RonAaron61/MyEIT-V1.2/Assets/PCB/README.md

Use EasyEda to open this file

How to use：

At editor, open the document via: Top menu - File - Open - EasyEDA... , and select the json file, then open it at the editor, you can save it into a project.
