RonAaron61/MyEIT-V1.2/Assets/Program/Python/EIT_LIVE_JAC/eit_reconstruct_jac.py

from __future__ import absolute_import, division, print_function

import matplotlib.pyplot as plt
from matplotlib import colors
import numpy as np
#import pyeit.eit.bp as bp
import pyeit.eit.jac as jac
import pyeit.eit.protocol as protocol
import pyeit.mesh as mesh
from pyeit.eit.fem import EITForward
from pyeit.mesh import shape, distmesh, plot_distmesh
from pyeit.mesh.wrapper import PyEITAnomaly_Circle

import average  #Untuk merata-rata satu data aja

class EIT_reconstruct:
    def __init__ (self, data, reference = None, use_ref = 0, n_el = 16, use_shape = 3):
        self.n_el = n_el  # nb of electrodes
        self.use_shape = use_shape
        self.data = data
        self.reference = reference
        self.use_ref = use_ref
    
    def Reconstruct(self):

        """ 0. build mesh """
        if self.use_shape == 1:
            # Mesh shape is specified with fd parameter in the instantiation, e.g : fd=thorax
            # mesh_obj = mesh.create(n_el, h0=0.1, fd=thorax)
            mesh_obj = mesh.layer_circle(self.n_el, n_fan=15, n_layer=20)
            # n_fan dan n_layer diutak-atik buat jumlah mesh
        elif self.use_shape == 2:
            """Bulat biasa"""
            mesh_obj = mesh.create(self.n_el, h0=0.04)
            #h0 -> menentukan jumlah mesh
        elif self.use_shape == 3 :
            """unit circle mesh - Bulat dengan distmesh kyk eidors"""
            """ #Note: Buat make ini awal2 harus ngutak-ngatik di plot_mesh.py dulu, dan __init__.py nya"""
            def _fd(pts):
                """shape function"""
                return shape.circle(pts, pc=[0, 0], r=1.0)

            def _fh(pts):
                """distance function"""
                r2 = np.sum(pts**2, axis=1)
                return 0.2 * (2.0 - r2)

            # build fix points, may be used as the position for electrodes
            p_fix = shape.fix_points_circle(ppl=self.n_el)
            # firs num nodes are the positions for electrodes
            el_pos = np.arange(self.n_el)

            # build triangle
            #p, t = distmesh.build(_fd, _fh, pfix=p_fix, h0=0.05)
            mesh_obj = mesh.create(fd=_fd, fh=_fh, p_fix=p_fix, h0=0.024)
            #plot_distmesh(p, t, el_pos)
        elif self.use_shape == 4:
            mesh_obj = mesh.create(self.n_el, h0=0.1, fd=thorax)

        el_pos = mesh_obj.el_pos


        """ 1. FEM forward simulations """
        # setup EIT scan conditions
        # adjacent stimulation (dist_exc=1), adjacent measures (step_meas=1)
        protocol_obj = protocol.create(self.n_el, dist_exc=1, step_meas=1, parser_meas="std")
        print("Mesh done...")


        """ 2. naive inverse solver using back-projection """
        """BP Mehtohd"""
        #eit = bp.BP(mesh_obj, protocol_obj) #Backpropagation
        #eit.setup(weight="simple")  #Lebih bagus pake ini
        
        """JAC Mehod"""
        eit = jac.JAC(mesh_obj, protocol_obj)
        eit.setup(p=0.5, lamb=0.01, method="kotre", perm=1, jac_normalized=False)
        
        #eit.setup(weight="None")


        """ 3. Input Data """
        if self.use_ref == 1:     #Use existing reference data
            referenceData = np.array(self.reference)
            

        elif self.use_ref == 0:   #Create reference data from data
            referenceData = average.ave(data=self.data, n_elec=self.n_el)
            #referenceData = None

        #data = np.loadtxt('2_VrmsSpidolLogam20Knew3.csv', delimiter=',', dtype=float)   
        print("Input Data Done...")


        """ 4. Inverse Problem """
        node_ds = 192.0 * eit.solve(self.data, referenceData, normalize=True)
        #node_ds = 192.0 * eit.gn(self.data, referenceData, lamb_decay=0.1, lamb_min=1e-5, maxiter=20, verbose=True)

        # extract node, element, alpha
        pts = mesh_obj.node
        tri = mesh_obj.element

        """ Plot Hasil """
        print("Plotting result...")
        #Draw the number of electrode
        def dot_num(x, y, axn, n):
            elect = [1,2,3,4,5,6,7,8,9,10,11,12,13,14,15,16]
            for i in range(len(n)):
                el2 = el_pos[i]
                el = elect[i]
                xi = x[el2, 0]
                yi = y[el2, 1]
                offset = 0.06
                if round(xi,3) > 0:
                    xt = xi+offset-0.04       
                elif round(xi,3) < 0:
                    xt = xi-offset
                else:
                    xt = xi
                
                if round(yi,3) > 0:
                    yt = yi+offset-0.04
                elif round(yi,3) < 0:
                    yt = yi-offset
                else:
                    yt = yi

                axn.annotate(el, xy=(xt,yt))
        # draw
        fig, axes = plt.subplots(1, 1, constrained_layout=True, figsize=(6, 6))


        # Mesh - plot the mesh
        """ax2 = axes[0]
        ax2.triplot(pts[:, 0], pts[:, 1], tri, linewidth=1) #pts[:, 1], pts[:, 0] -> kebalik urutan elekt nya
        ax2.plot(pts[el_pos, 0], pts[el_pos, 1], "ro")
        #dot_num(pts, pts, ax2, pts[el_pos, 1])
        ax2.axis("equal")
        ax2.axis([-1.2, 1.2, -1.2, 1.2])
        title_src = (
            "number of triangles = "
            + str(np.size(tri, 0))
            + ", "
            + "number of nodes = "
            + str(np.size(pts, 0))
        )
        ax2.set_title(title_src)"""

        # reconstructed
        ax1 = axes
        ax1.set_title(r"Reconstituted $\Delta$ Conductivities")
        ax1.axis("equal")
        ax1.plot(pts[el_pos, 0], pts[el_pos, 1],"ro")
        im = ax1.tripcolor(
            pts[:, 0],
            pts[:, 1],
            tri,
            np.real(node_ds),
            #edgecolor="k", #Buat nampilin bentuk mesh
            shading="flat",
            alpha=1,
            cmap=plt.cm.twilight_shifted,    #For colormap -> https://matplotlib.org/stable/gallery/color/colormap_reference.html
            norm = colors.CenteredNorm() #Biar colormap nya gk geser2
            
            #Kalo mau warnanya di kontrasin ->
            #norm = colors.BoundaryNorm(boundaries=np.linspace(-13, 13, 6), ncolors=256, extend='both'),
            #cmap = 'RdBu_r'
        )
        #dot_num(pts, pts, ax1, pts[el_pos, 1])
        x, y = pts[:, 0], pts[:, 1]
        for i, e in enumerate(mesh_obj.el_pos):
            ax1.annotate(str(i + 1), xy=(x[e], y[e]), color="b")

        # 'tricontour' interpolates values on nodes, for example
        # ax.tricontour(pts[:, 0], pts[:, 1], tri, np.real(node_ds),
        # shading='flat', alpha=1.0, linewidths=1,
        # cmap=plt.cm.RdBu)
        fig.colorbar(im)
        #fig.colorbar(im, ax=axes.ravel().tolist())
        #mng = plt.get_current_fig_manager()
        #mng.full_screen_toggle()

        #plt.show()  #Jangan lupa di Full screen dulu baru di close kalo mau disave image nya fullscreen
        return plt.show()
        #fig.savefig('ReferensiRATARATA.png', dpi=96, bbox_inches='tight')

if __name__ == '__main__':
    #data = np.loadtxt('2_VrmsSpidolLogam20Knew3.csv', delimiter=',', dtype=float) 
    #reconstruct = EIT_reconstruct(data=data, use_ref=0, n_el=16)

    reference = [1.809055, 0.8100247, 0.3967621, 0.3232599, 0.2467575, 0.2371947, 0.2000686, 0.2242568, 0.2328821, 0.3315101, 0.4357633, 0.7938993, 1.722053, 1.916683, 0.6648952, 0.4732644, 0.3185722, 0.2756334, 0.212444, 0.2175066, 0.2066313, 0.2668206, 0.3076969, 0.4689518, 0.7428976, 1.928871, 1.819368, 1.271664, 0.8216501, 0.4655767, 0.3549483, 0.2473201, 0.2311945, 0.2015687, 0.2370072, 0.2471325, 0.3339477, 0.4466386, 0.8539011, 0.8171499, 1.900558, 2.138315, 0.8734017, 0.5514544, 0.3390104, 0.2850087, 0.2266944, 0.2435699, 0.2310071, 0.2806961, 0.3288851, 0.5193909, 0.4051999, 0.688896, 1.580673, 1.295852, 0.769336, 0.3965746, 0.294009, 0.211694, 0.2085064, 0.1811305, 0.2011936, 0.2133815, 0.2990716, 0.3318851, 0.4730769, 0.8295254, 2.169629, 1.773054, 0.7462728, 0.4708269, 0.3041343, 0.2718833, 0.2169441, 0.2220068, 0.2158191, 0.2731958, 0.2561328, 0.3174472, 0.4730769, 0.8786518, 1.375729, 1.538297, 0.7736486, 0.4232004, 0.3345102, 0.2411324, 0.2248194, 0.2002561, 0.230632, 0.24432, 0.2711333, 0.3583234, 0.5512669, 0.7338974, 1.912933, 1.978748, 0.8057121, 0.5321412, 0.3388228, 0.2850087, 0.230632, 0.2415074, 0.2079438, 0.2092564, 0.2516327, 0.3401354, 0.3984497, 0.7468353, 1.493483, 1.641237, 0.8077746, 0.4305131, 0.3193222, 0.2336321, 0.2233193, 0.2321321, 0.2137565, 0.2362572, 0.2857587, 0.2956965, 0.4717644, 0.7749611, 1.87562, 2.026749, 0.7914617, 0.49239, 0.3202598, 0.2746959, 0.2401948, 0.2023187, 0.2055063, 0.2268819, 0.2130065, 0.3043218, 0.4239504, 0.807774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
    reconstruct = EIT_reconstruct(data=data, reference=reference, use_ref=1, n_el=16)

    reconstruct.Reconstruct()
